UCI-Rocket-Project/rocket2-ami/IMUAxes.dxf

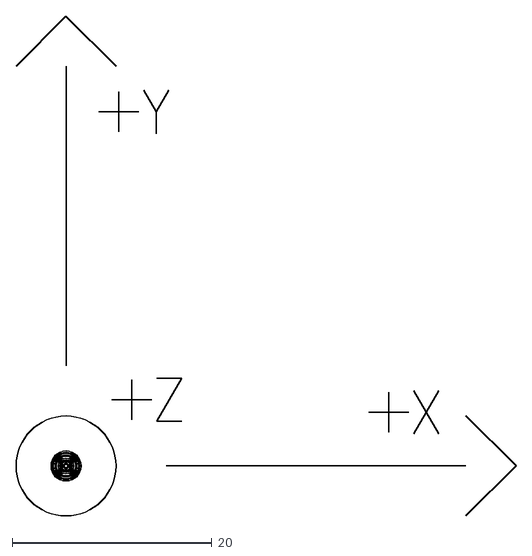
[picture p1: CAD file, 2026-10-05]
IMUAxes.dxf
50.0 x 50.0
