UCI-Rocket-Project/rocket2-ami/VXL.dxf

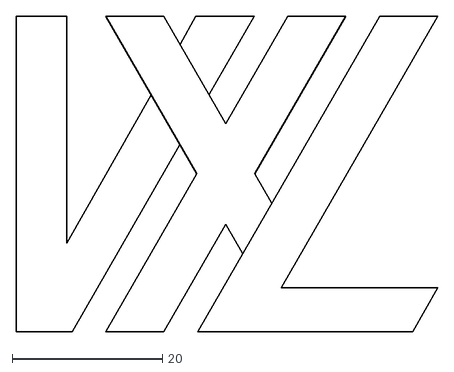
[picture p2: CAD file, 2026-10-05]
VXL.dxf
56.1 x 41.9
