UCI-Rocket-Project/rocket2-ami/rocket2-ami.kicad_pcb

## KiCad design rocket2-ami.kicad_pcb (2026-10-17)

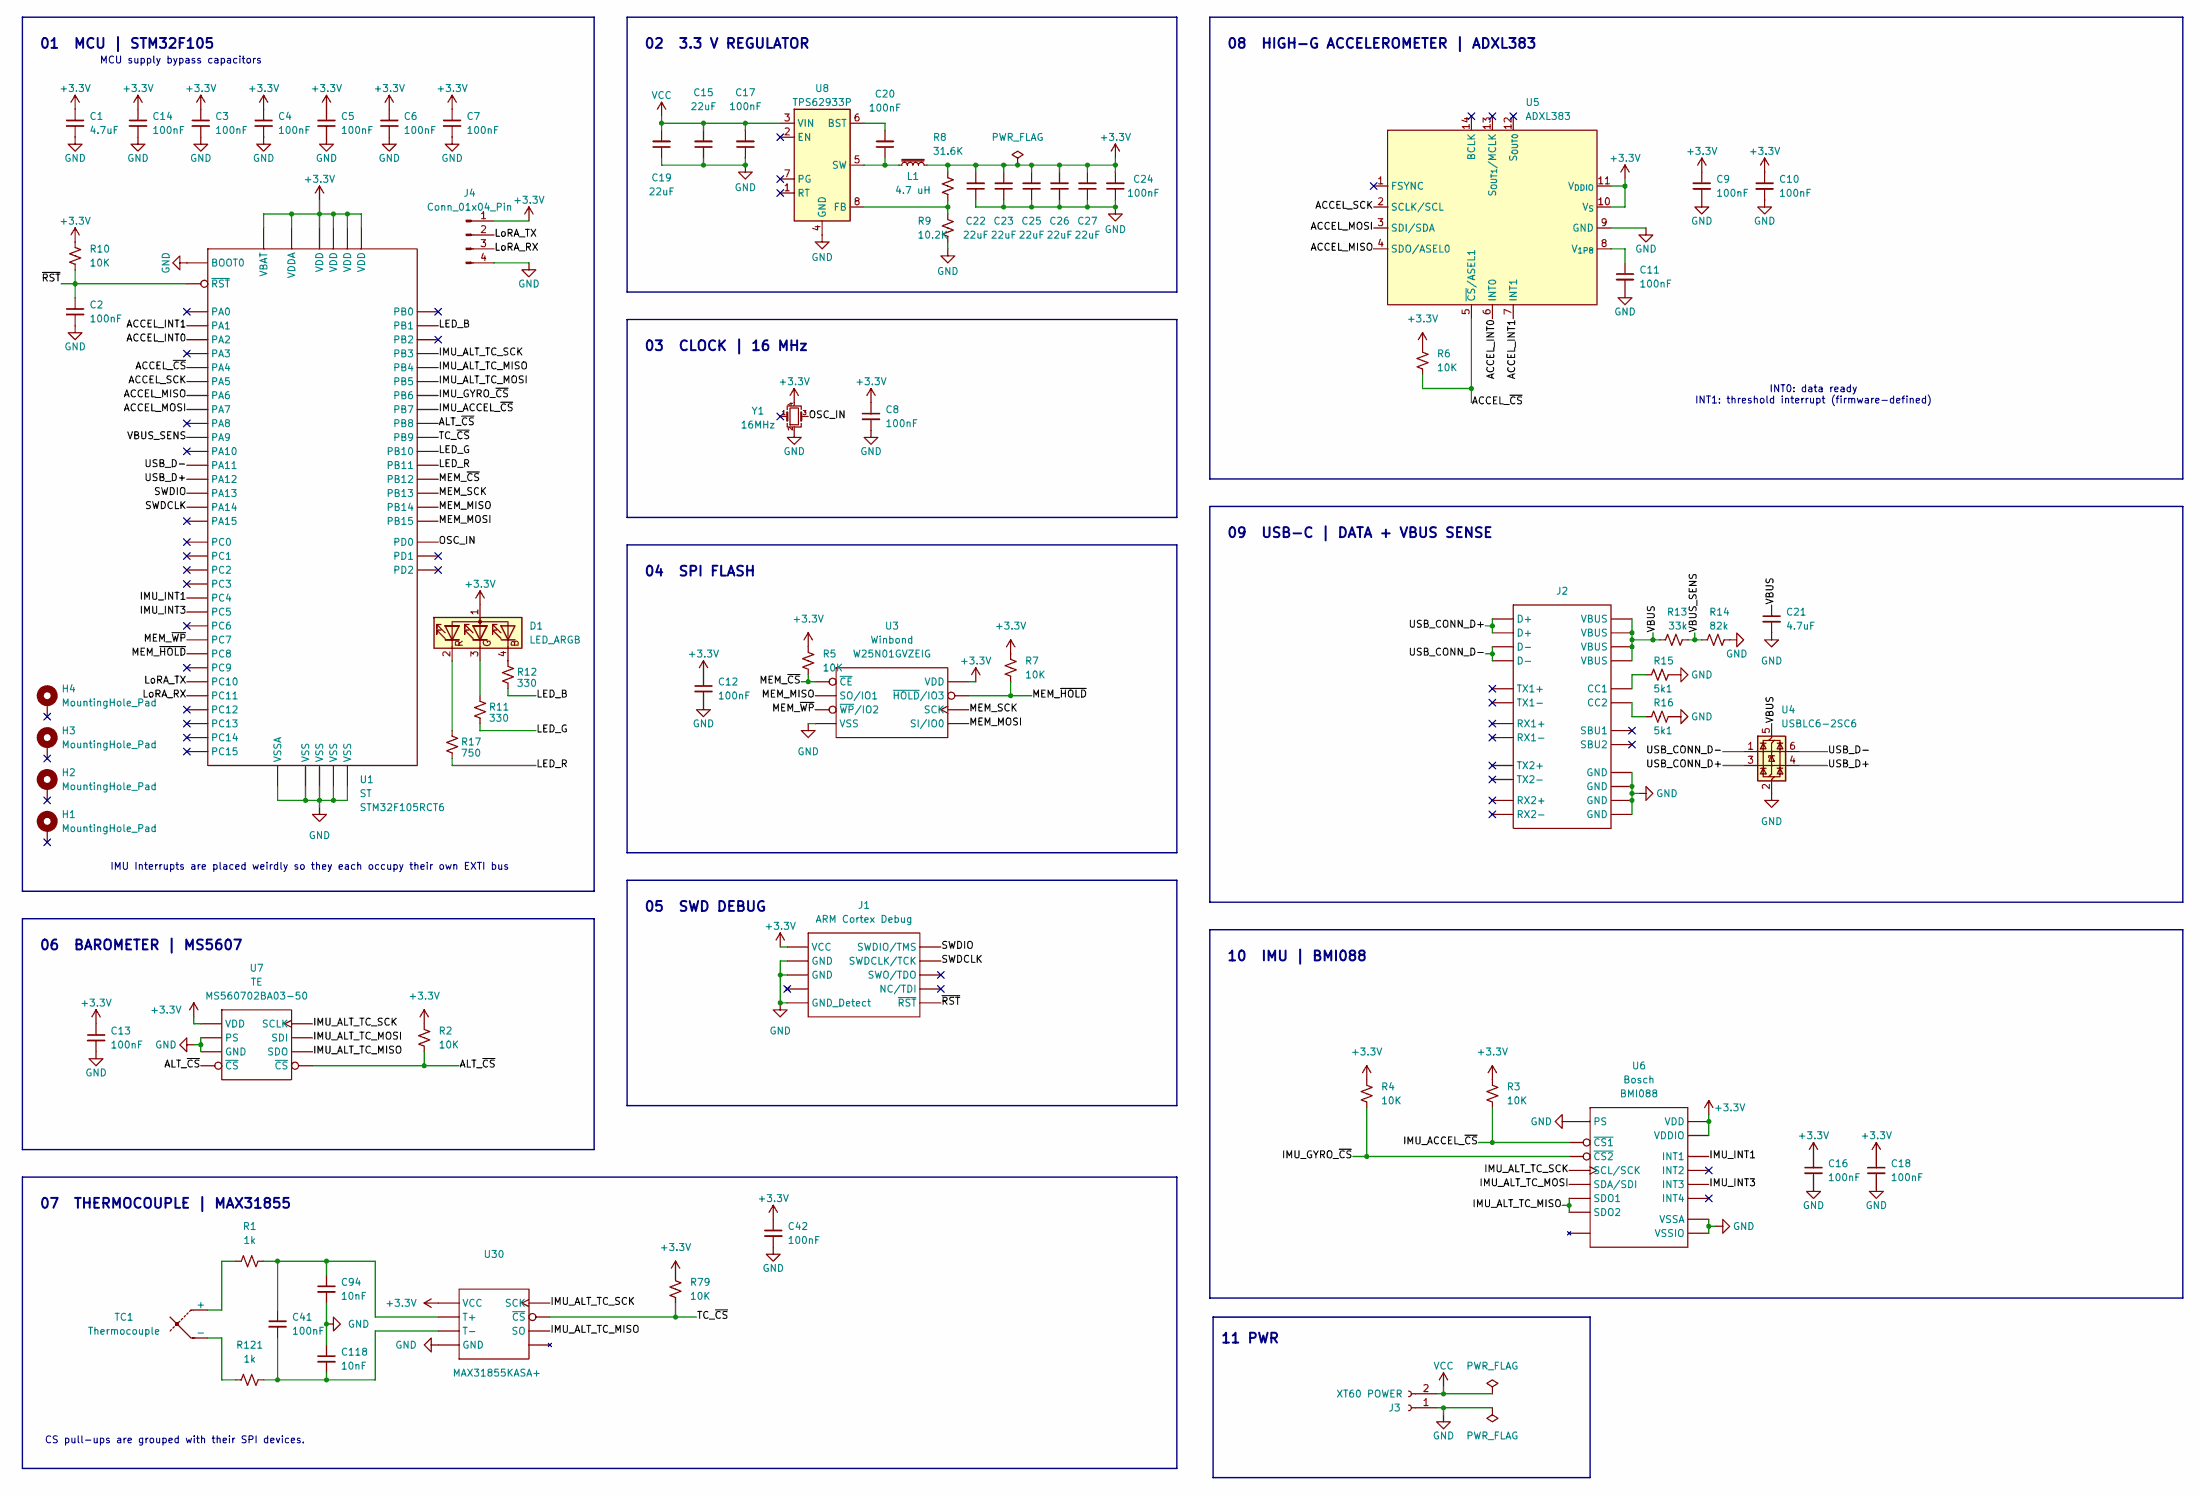
[picture p3: schematic rocket2-ami.kicad_sch, AFS2 | Flight Computer]

Parts:
C1: 4.7uF; C_0603_1608Metric; Part # Generic 4.7uF 6.3V X7R 0603 MLCC
C2, C3, C4, C5, C6, C7, C8, C9, C10, C11, C12, C13, C14, C16, C18, C20, C24: 100nF; C_0603_1608Metric; Part # Generic 0603 6.3V 100nF X7R MLCC
C15, C19: 22uF; C_0603_1608Metric; Part # Generic 0603 16V 22uF X5R MLCC
C17: 100nF; C_0603_1608Metric; Part # Generic 0603 50V 100nF X7R MLCC
C21: 4.7uF; C_0603_1608Metric; Part # Generic 0603 6.3V 4.7uF X7R MLCC
C22, C23, C25, C26, C27: 22uF; C_0603_1608Metric; Part # Generic 0603 6.3V 22uF X5R MLCC
C41, C42: 100nF; C_0402_1005Metric; Part # GRM155R71H104KE14D
C94, C118: 10nF; C_0402_1005Metric; Part # GRM155R71H103KA88D
D1: LED_ARGB; LED RGB (0606) APTF1616LSEEZGKQBKC
H1, H2, H3, H4: MountingHole_Pad; MountingHole_3.2mm_M3_Pad_Via
J1: ARM Cortex Debug; PinHeader_2x05_P1.27mm_Vertical_SMD
J2: USB_C_Receptacle_GCT_USB4105-xx-A_16P_TopMnt_Horizontal; Part # USB4105-GF-A
J3: XT60 POWER; AMASS_XT60PW-M_1x02_P7.20mm_Horizontal; Part # Generic Horizontal TH P5.08mm Screw Fas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
J4: Conn_01x04_Pin; PinHeader_1x04_P2.54mm_Vertical
L1: 4.7 uH; Inductor (4.7uH) IND_03-4R7-R_EAT
R1, R121: 1k; R_0402_1005Metric; Part # RC0402FR-071KL
R2, R3, R4, R5, R6, R7, R10, R79: 10K; R_0402_1005Metric; Part # RC0402FR-0710KL
R8: 31.6K; R_0402_1005Metric
R9: 10.2K; R_0402_1005Metric; Part # Generic RES SMD 10K OHM 1% 1/16W 0402
R11, R12: 330; R_0402_1005Metric; Part # RC0402FR-07330RL
R13: 33k; R_0603_1608Metric; Part # RC0603FR-0733KL
R14: 82k; R_0603_1608Metric; Part # RC0603FR-0782KL
R15, R16: 5k1; R_0603_1608Metric; Part # CRCW06035K10FKEA
R17: 750; R_0402_1005Metric; Part # RC0402FR-07750RL
TC1: Thermocouple; TC_Connector AM-K-PCB; Part # AM-K-PCB
U1: STM32F105RCT6; MCU STM32F105RCT6; Part # STM32F105RCT6
U3: WSON-8-1EP_8x6mm_P1.27mm_EP3.4x4.3mm; Part # W25N01GVZEIG
U4: USBLC6-2SC6; SOT-23-6
U5: ADXL383; 14_LGA
U6: IMU BMI088; Part # BMI088
U7: Altimeter MS5607-02BA; Part # MS560702BA03-50
U8: TPS62933P; SOT-583-8
U30: SOIC-8_3.9x4.9mm_P1.27mm; Part # MAX31855KASA+
Y1: 16MHz; Crystal_SMD_2016-4Pin_2.0x1.6mm; Part # ECS-1633-160-BN-TR

Connections:
+3.3V: C1.1, C3.1, C4.1, C5.1, C6.1, C7.1, C8.1, C9.1, C10.1, C12.1, C13.1, C14.1, C16.1, C18.1, C22.2, C23.2, C24.2, C25.2, C26.2, C27.2, C42.1, D1.1 (A), J1.1 (VCC), J4.1, L1.2, R2.1, R3.1, R4.1, R5.1, R6.1, R7.1, R8.1, R10.1, R79.1, U1.1 (VBAT), U1.13 (VDDA), U1.19 (VDD), U1.32 (VDD), U1.48 (VDD), U1.64 (VDD), U3.8 (VDD), U5.10 (V_{S}), U5.11 (V_{DDIO}), U6.3 (VDD), U6.11 (VDDIO), U7.1 (VDD), U30.4 (VCC), Y1.4
/ACCEL_INT0: U1.16 (PA2), U5.6 (INT0)
/ACCEL_INT1: U1.15 (PA1), U5.7 (INT1)
/ACCEL_MISO: U1.22 (PA6), U5.4 (SDO/ASEL0)
/ACCEL_MOSI: U1.23 (PA7), U5.3 (SDI/SDA)
/ACCEL_SCK: U1.21 (PA5), U5.2 (SCLK/SCL)
/ACCEL_~CS: R6.2, U1.20 (PA4), U5.5 (~CS/ASEL1)
/ALT_~CS: R2.2, U1.61 (PB8), U7.4 (~CS), U7.5 (~CS)
/IMU_ACCEL_~CS: R3.2, U1.59 (PB7), U6.14 (~CS1)
/IMU_ALT_TC_MISO: U1.56 (PB4), U6.10 (SDO2), U6.15 (SDO1), U7.6 (SDO), U30.7 (SO)
/IMU_ALT_TC_MOSI: U1.57 (PB5), U6.9 (SDA/SDI), U7.7 (SDI)
/IMU_ALT_TC_SCK: U1.55 (PB3), U6.8 (SCL/SCK), U7.8 (SCLK), U30.5 (SCK)
/IMU_GYRO_~CS: R4.2, U1.58 (PB6), U6.5 (~CS2)
/IMU_INT1: U1.24 (PC4), U6.16 (INT1)
/IMU_INT3: U1.25 (PC5), U6.12 (INT3)
/LED_B: R12.2, U1.27 (PB1)
/LED_G: R11.2, U1.29 (PB10)
/LED_R: R17.2, U1.30 (PB11)
/LoRA_RX: J4.3, U1.52 (PC11)
/LoRA_TX: J4.2, U1.51 (PC10)
/MEM_MISO: U1.35 (PB14), U3.2 (SO/IO1)
/MEM_MOSI: U1.36 (PB15), U3.5 (SI/IO0)
/MEM_SCK: U1.34 (PB13), U3.6 (SCK)
/MEM_~CS: R5.2, U1.33 (PB12), U3.1 (~CE)
/MEM_~HOLD: R7.2, U1.39 (PC8), U3.7 (~HOLD/IO3)
/MEM_~WP: U1.38 (PC7), U3.3 (~WP/IO2)
/OSC_IN: U1.5 (PD0), Y1.3
/SWDCLK: J1.4 (SWDCLK/TCK), U1.49 (PA14)
/SWDIO: J1.2 (SWDIO/TMS), U1.46 (PA13)
/TC_~CS: R79.2, U1.62 (PB9), U30.6 (~CS)
/USB_CONN_D+: J2.A6 (D+), J2.B6 (D+), U4.3 (I/O2)
/USB_CONN_D-: J2.A7 (D-), J2.B7 (D-), U4.1 (I/O1)
/USB_D+: U1.45 (PA12), U4.4 (I/O2)
/USB_D-: U1.44 (PA11), U4.6 (I/O1)
/VBUS: C21.1, J2.A4 (VBUS), J2.A9 (VBUS), J2.B4 (VBUS), J2.B9 (VBUS), R13.1, U4.5 (VBUS)
/VBUS_SENS: R13.2, R14.2, U1.42 (PA9)
/~RST: C2.1, J1.10 (~RST), R10.2, U1.7 (~RST)
GND: C1.2, C2.2, C3.2, C4.2, C5.2, C6.2, C7.2, C8.2, C9.2, C10.2, C11.2, C12.2, C13.2, C14.2, C15.1, C16.2, C17.1, C18.2, C19.1, C21.2, C22.1, C23.1, C24.1, C25.1, C26.1, C27.1, C42.2, C94.2, C118.1, J1.3 (GND), J1.5 (GND), J1.9 (GND_Detect), J2.A1 (GND), J2.A12 (GND), J2.B1 (GND), J2.B12 (GND), J3.1, J4.4, R9.2, R14.1, R15.1, R16.1, U1.12 (VSSA), U1.18 (VSS), U1.31 (VSS), U1.47 (VSS), U1.60 (BOOT0), U1.63 (VSS), U3.4 (VSS), U4.2 (GND), U5.9 (GND), U6.4 (VSSA), U6.6 (VSSIO), U6.7 (PS), U7.2 (PS), U7.3 (GND), U8.4 (GND), U30.1 (GND), Y1.2 (G)
unnamed: D1.4 (BK), R12.1
unnamed: D1.3 (GK), R11.1
unnamed: D1.2 (RK), R17.1
unnamed: J2.A5 (CC1), R15.2
unnamed: J2.B5 (CC2), R16.2
unnamed: R1.1, TC1.1 (+)
unnamed: R121.1, TC1.2 (-)
unnamed: C11.1, U5.8 (V_{1P8})
unnamed: C20.2, U8.6 (BST)
unnamed: R8.2, R9.1, U8.8 (FB)
unnamed: C20.1, L1.1, U8.5 (SW)
unnamed: C41.1, C94.1, R1.2, U30.3 (T+)
unnamed: C41.2, C118.2, R121.2, U30.2 (T-)
VCC: C15.2, C17.2, C19.2, J3.2, U8.3 (VIN)

Notes on the sheet:
IMU Interrupts are placed weirdly so they each occupy their own EXTI bus
07 THERMOCOUPLE | MAX31855
10 IMU | BMI088
MCU supply bypass capacitors
02 3.3 V REGULATOR
05 SWD DEBUG
09 USB-C | DATA + VBUS SENSE
03 CLOCK | 16 MHz
INT0: data ready INT1: threshold interrupt (firmware-defined)
06 BAROMETER | MS5607
04 SPI FLASH
11 PWR
01 MCU | STM32F105
08 HIGH-G ACCELEROMETER | ADXL383
CS pull-ups are grouped with their SPI devices.

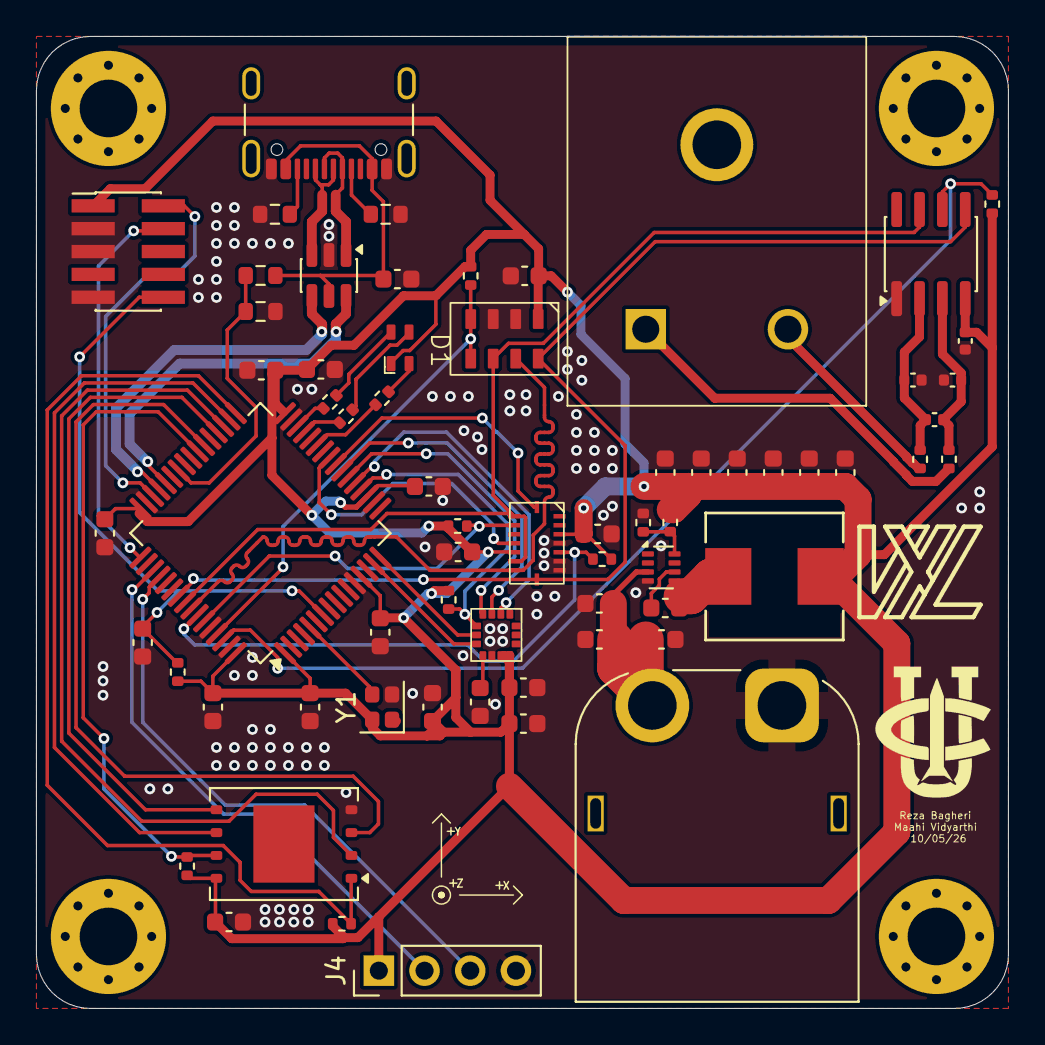
[picture p4: board rocket2-ami.kicad_pcb from above]

Board: 2 copper layers, 54.0 x 54.0 mm, 70 parts (0 on the bottom side), 52 nets.
