UCI-Rocket-Project/rocket2-ami/(commit log)

2026-09-30 Not cleaned up, missing power, has TC. no layout
    [rocket2-afs2.kicad_pcb, rocket2-afs2.kicad_sch]
2026-09-30 Tmp staging ground cleaned up with astra and then improved schematic some more
    [rocket2-afs2-cleaned.kicad_sch]
2026-10-05 Finished routing iteration 1. Going to try moving everything to the front next
    [60gAccelAxes.dxf, IMUAxes.dxf, VXL.dxf, rocket2-afs2-cleaned.kicad_sch, rocket2-afs2.kicad_pcb, rocket2-afs2.kicad_sch]
2026-10-05 Moved all to front
    [60gAccelAxes.dxf, rocket2-afs2.kicad_pcb, rocket2-afs2.kicad_sch]
2026-10-06 I can't lie I don't know what I changed but it wouldn't let me close without saving so I'm committing just in case
    [rocket2-afs2.kicad_pcb]
2026-10-07 Ready for PDR. Might still mess around more but its all routed and passes
    [rocket2-afs2.kicad_pcb, rocket2-afs2.kicad_sch]
2026-10-07 Renamed to AMI
    [rocket2-ami.kicad_pcb, rocket2-ami.kicad_sch]
2026-10-08 Switched to buck convertor!
    [rocket2-ami.kicad_pcb, rocket2-ami.kicad_sch]
2026-10-08 Upgraded to 16 mhz clock (same as our other boards)
    [rocket2-ami.kicad_pcb, rocket2-ami.kicad_sch]
2026-10-08 Updated schematic & layout to remove all ERC & DRC errors & all ERC warnings
    [rocket2-ami.kicad_pcb, rocket2-ami.kicad_sch]
2026-10-11 Added LED and UART
2026-10-17 Ordering off of this generated gerber
2026-11-02 Changed BOM slightly to match IRL
2026-11-02 Weird cuz rocket drivers is trolling but I added LED and task scheduler together.
2026-11-02 Updated drivers to match latest
2026-11-03 Added initial accel driver
2026-11-03 Added LED pulsing based on init status
2026-11-05 Generally works, LED uses a lookup table now so is much faster and the data collection doesnt falter. i want to rip out all the profiling and then come back later with spme better stuff to get the de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
2026-11-05 Added rocket drivers update
